nuggetbucket54/CanSat/README.md

# Team TurkeyBurkey CanSat

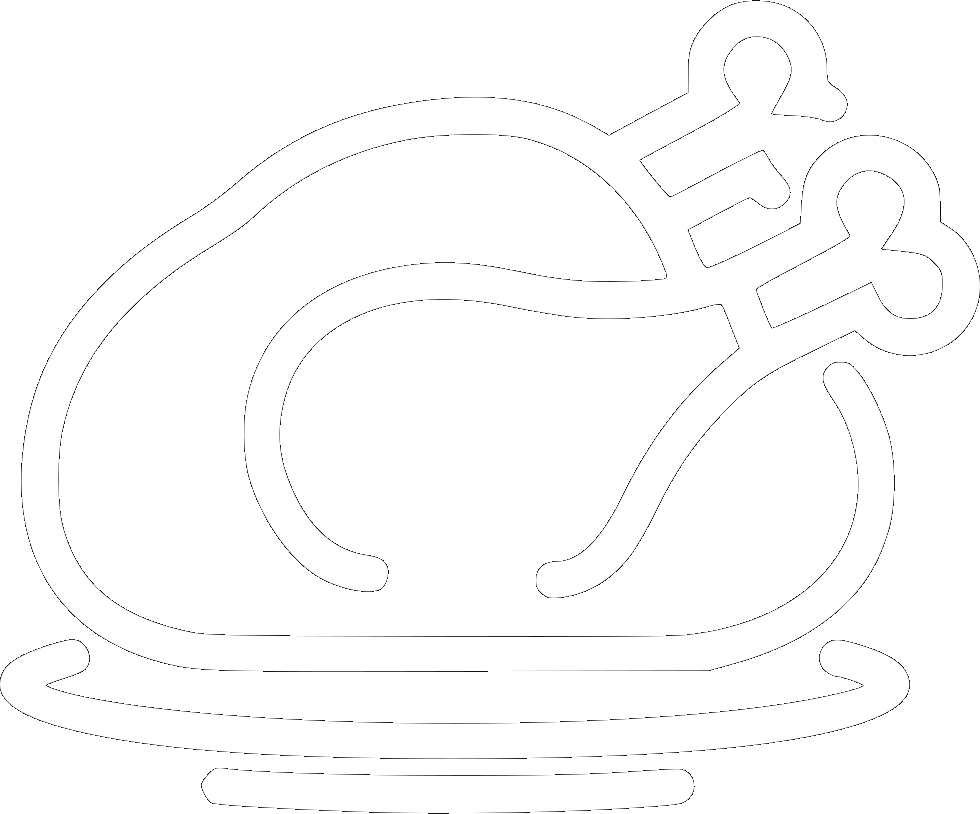
[picture p1: images/turk.png]
TurkeyBurkey Logo

  
Seismometers are both useful and precise when it comes to measuring earthquakes or tremors. In humanity’s ongoing efforts in interplanetary exploration, scientists have developed an abundance of methods to assess the inhabitability of celestial bodies. However, to our understanding, there is yet to be any way to remotely test seismic activities—one must conduct these tests on the surface of these planetary bodies.

Our CanSat converts the seismograph measurements to the Shindo scale and determine the magnitude of the tremors and accomplishes the following:

* Maintain structural and functional integrity while under the forces of launch/freefall.
* Collect air temperature and pressure data during freefall.
* Measure and record vibrations and tremors upon landing.
* Maintain a stable radio connection during freefall and landing over which experimental data may be transmitted.
* Receive accurate and precise data.

## Construction
The CanSat is built around the Arduino NANO V3. Etching and soldering our own circuit boards, these are the components used:
* MPU6050 gyro
* BN220 GPS sensor
* BMP180 barometric sensor
* RYLR896 LoRa radio transmitter/receiver

<p align="center">
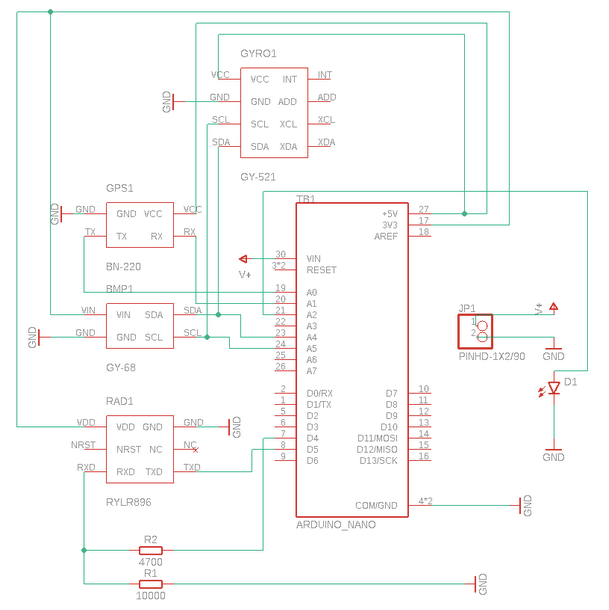
[picture p2: images/pcb.png]
  
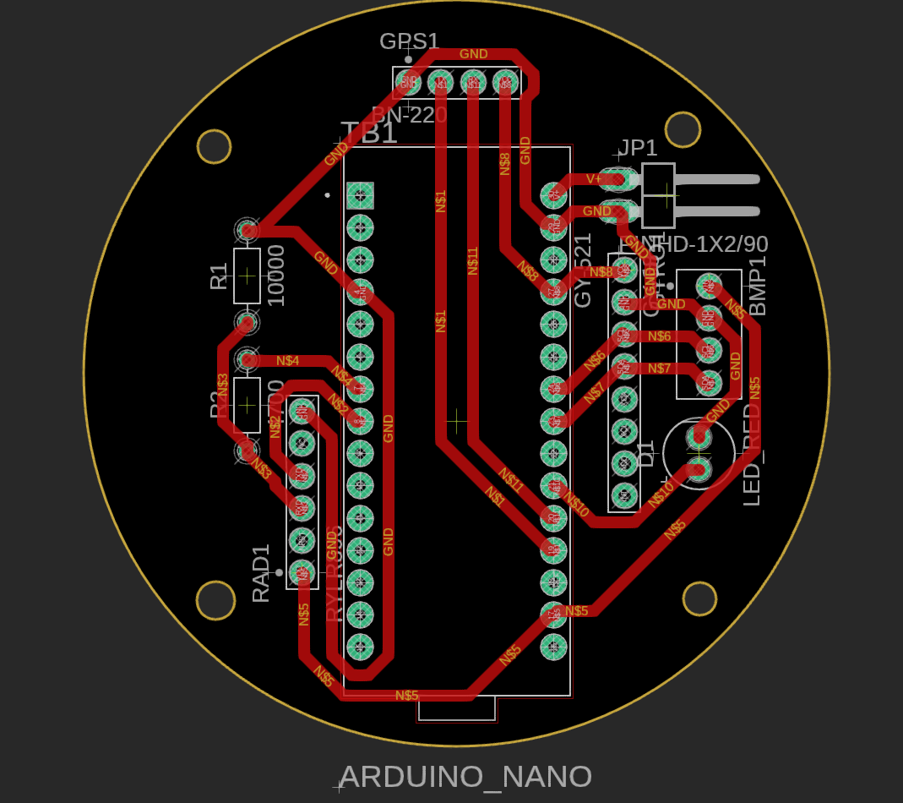
[picture p3: images/pcbdiagram.png]
  
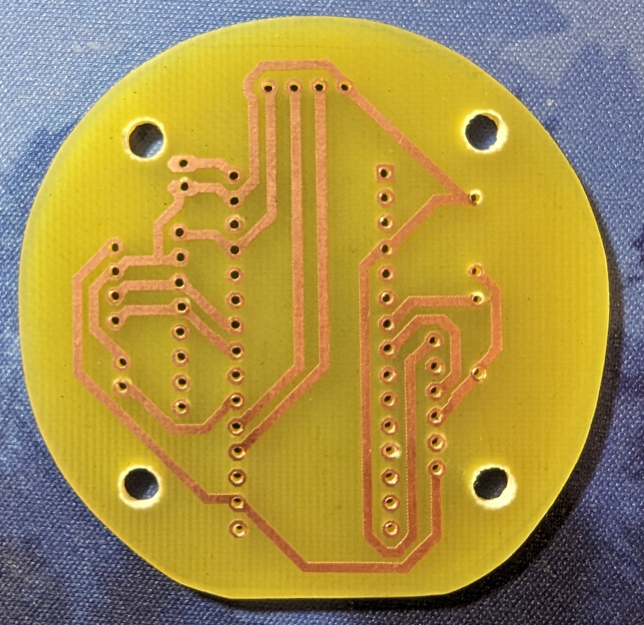
[picture p4: images/pcbetched.jpg]
   <br>
  (left to right) circuit diagram, PCB schematic, etched and drilled circuit <br> <br>
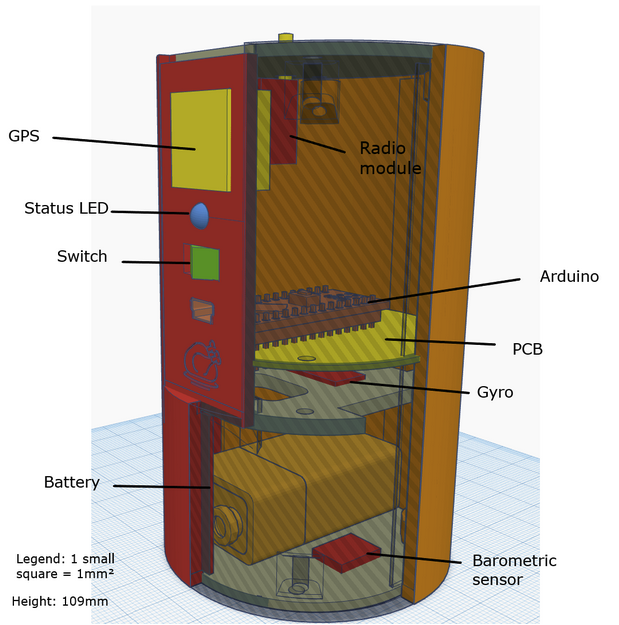
[picture p5: images/cansat.png]
   <br>
  A diagram showing how the CanSat fits together
</p>

## The Seismometer
Due to the size constraints of the CanSat, the accuracy of the seismometer was achieved through software rather than hardware, relying on an MPU6050 Arduino module. This gyro converts physical movements from seismic activity into electrical signals through the analog inputs of the arduino. The entire process of parsing this data has already been studied extensively by the Japanese Meteorological Agency (JMA) and has been further developed to meet the needs of our CanSat. Our process is as follows:

1.  Get the X, Y, and Z angles and calculate the X-, Y-, and Z-components of measured acceleration
2.  Take multiple measurements in a short span of time (in our case 12 measurements every 0.12 seconds)
3.  Apply a Fourier transform to the 12-item datasets for the two horizontal (X and Y) and single vertical (Z) acceleration components, separating each acceleration into multiple trigonometric functions

<p align="center">
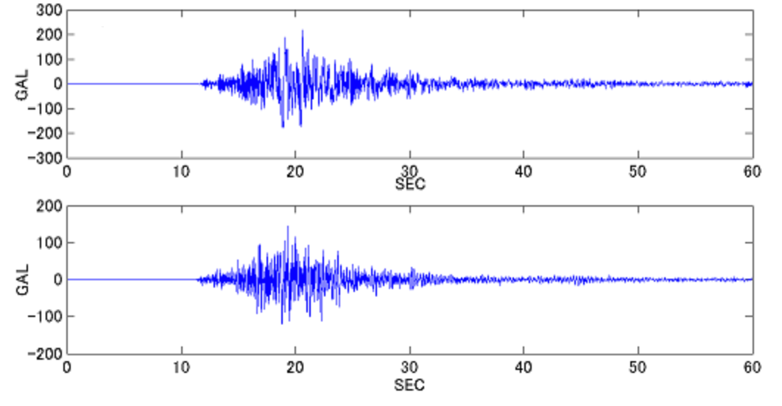
[picture p6: images/prefourier.png]
  
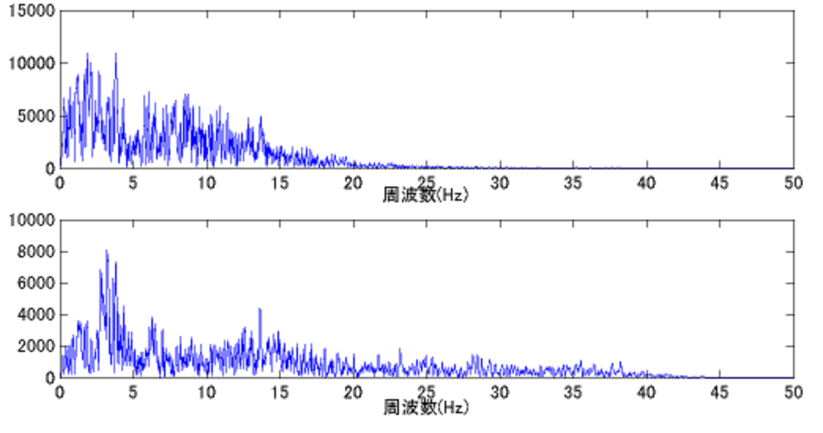
[picture p7: images/postfourier.png]
   <br>
  An example of a Fourier transform of seismometer data from the 2000 Earthquake in Tottori, Japan <br>
  (left) pre-Fourier transform, (right) post-Fourier transform
</p>

4.  Multiply these trigonometric functions by constants calculated by the JMA to “smooth” out the data, reducing instrumental noise

<p align="center">
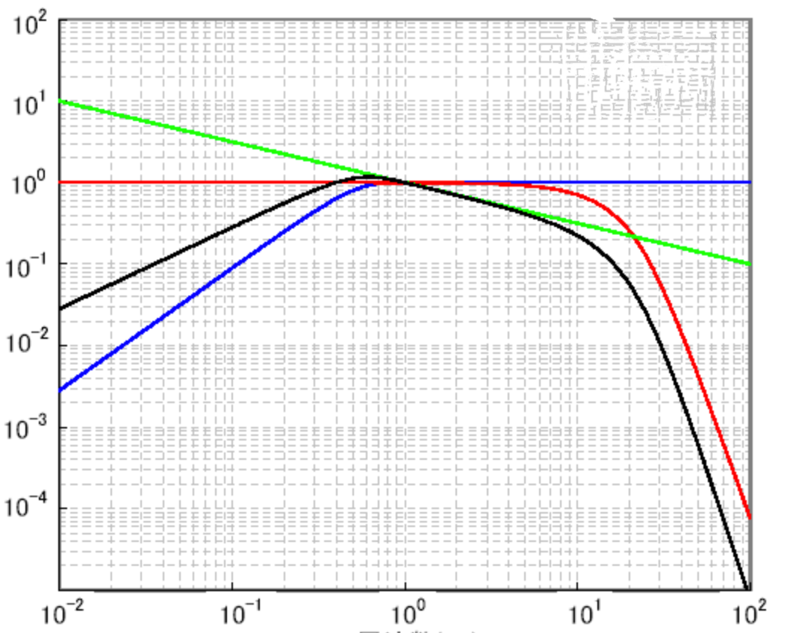
[picture p8: images/filters.png]
   <br>
  (blue) high-cut filter removing high noise, (red) low-cut filter removing low noise, (black) data, (green) filtered data
</p>

5.  Perform the inverse Fourier transform that was applied in step 3 to merge the trigonometric functions back into the respective X-, Y-, and Z-components
6.  Synthesize these three components into a single vector

<p align="center">
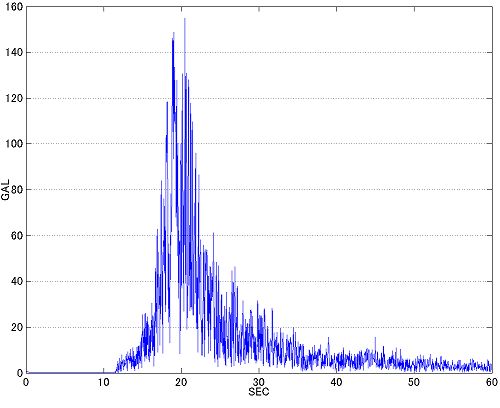
[picture p9: images/composite.PNG]
   <br>
  The composite of the acceleration calculated by the seismometer after compiling all filtered data
</p>

7.  Convert measurements into the Shindo scale using formula `Intensity = 2 log a + 0.94` where a is the acceleration of the synthesized vector in gals (1 cm/s^2)

## CanSat Results
### Launch
Unfortunately, the rocket in which TurkeyBurkey was launched in experienced unexpected results—the motor burnt through and prematurely released the CanSat, damaging our CanSat beyond repair

<p align="center">
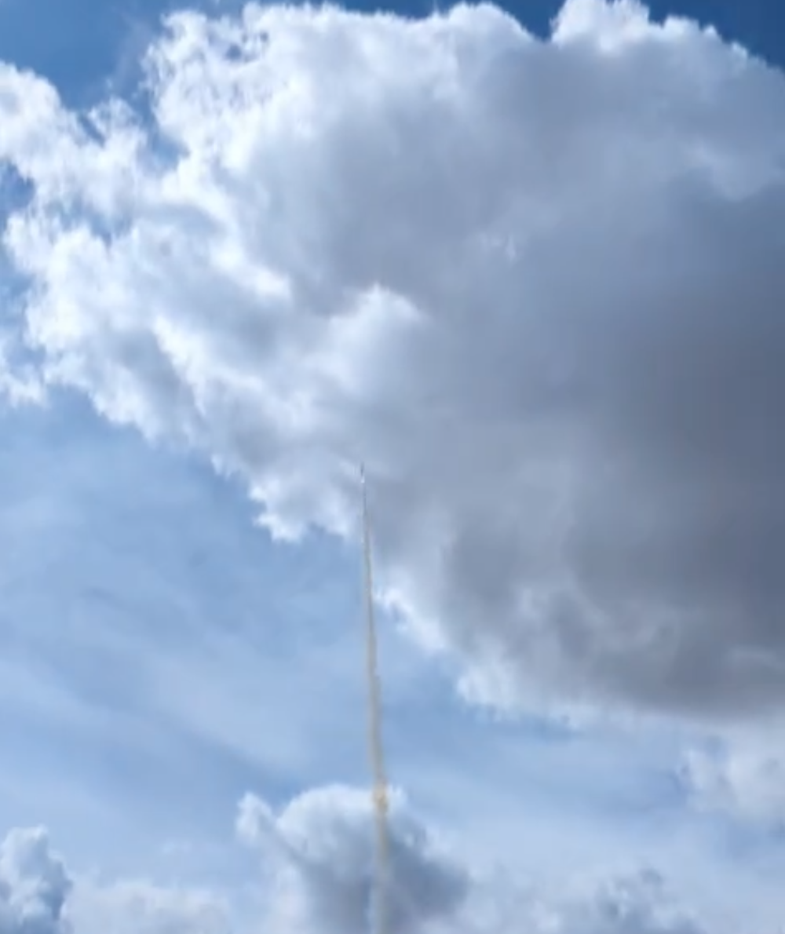
[picture p10: images/fail1.png]
  
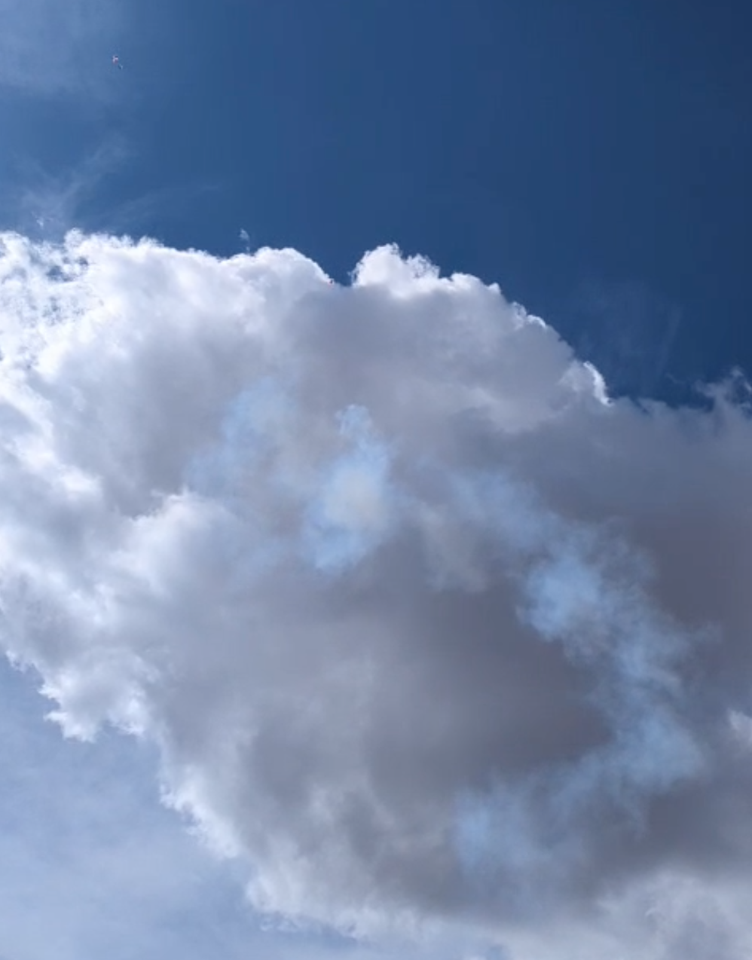
[picture p11: images/fail2.png]
  
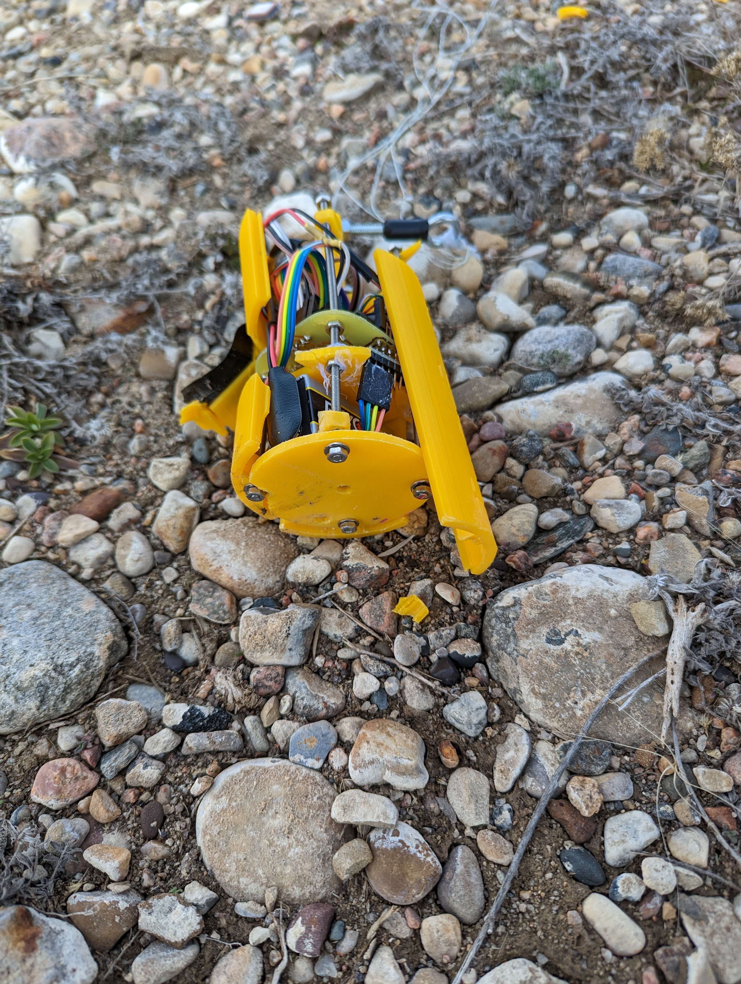
[picture p12: images/wreckage1.jpg]
  
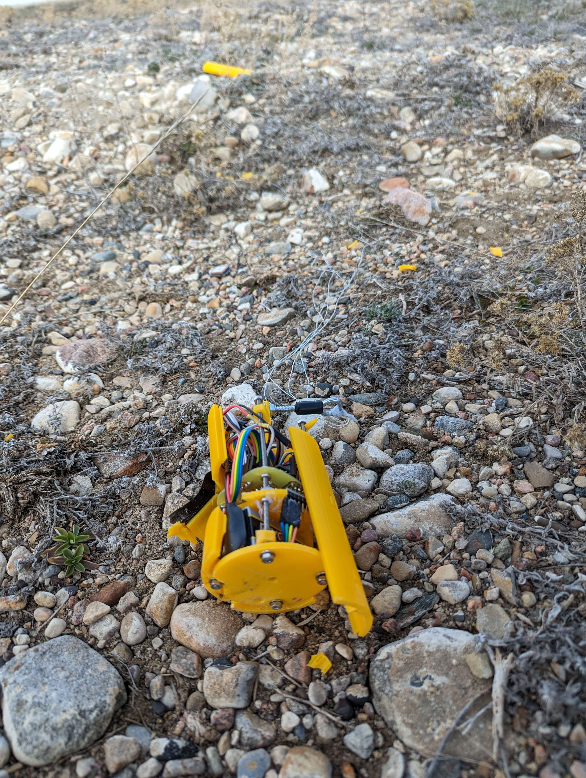
[picture p13: images/wreckage2.jpg]
   <br>
  (left to right) rocket burning out mid-launch, post-mortem CanSat 😔
</p>

### Findings
Due to the rapid unplanned disassembly of the CanSat, team TurkeyBurkey was only able to grab readings while on land and during initial launch (before the burnout of the motor). However, we were able to gather some interesting information nonetheless

<p align="center">
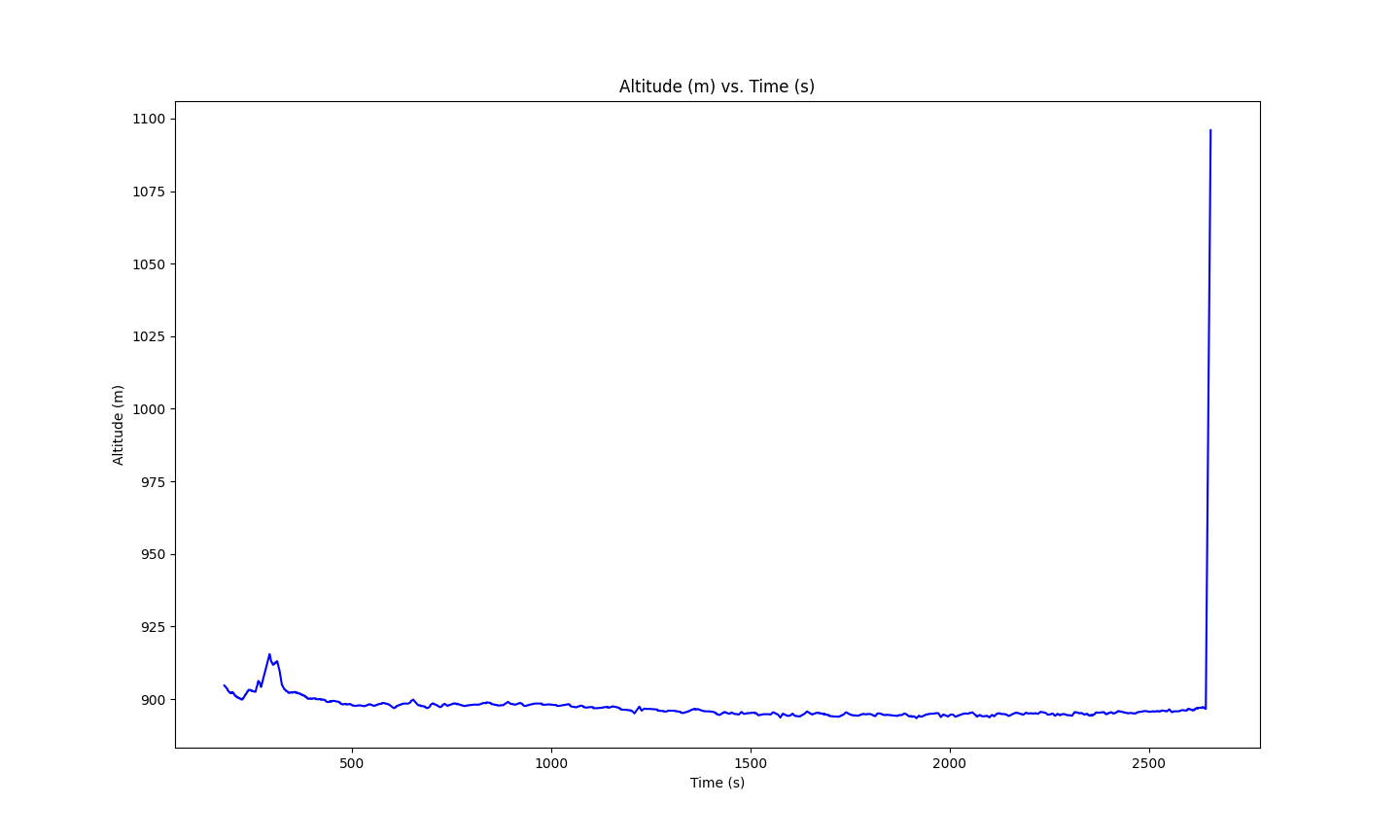
[picture p14: images/altitude-time.png]
   <br>
  The smaller peak likely comes from walking the CanSat to the launch site, while the larger peak comes from the moment of launch <br> <br>
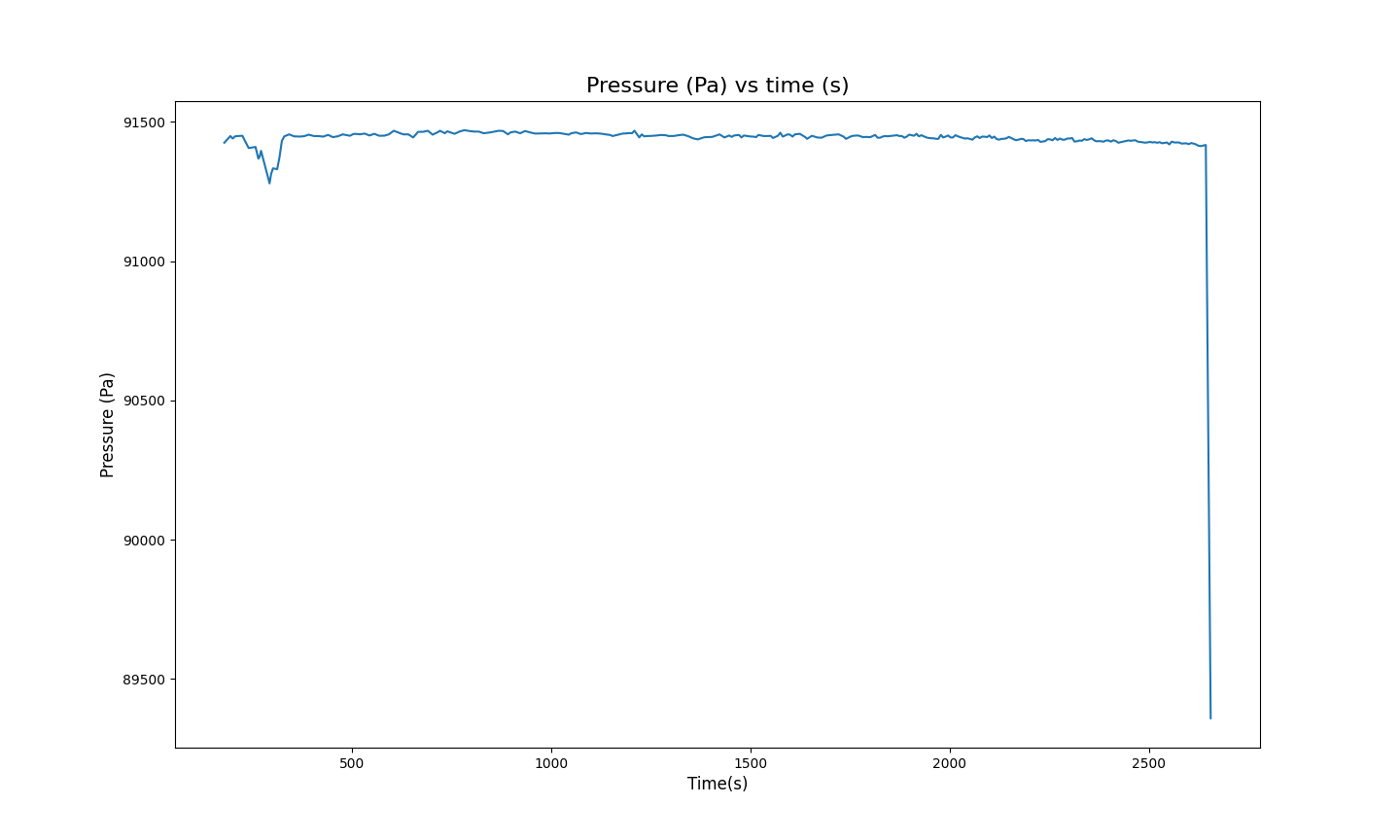
[picture p15: images/pressure-time.png]
   <br>
  The pressure remains relatively constant until the sudden launch of the rocket, in which the pressure quickly decreases. The earlier dip could be from fitting the satellite into the rocket <br> <br>
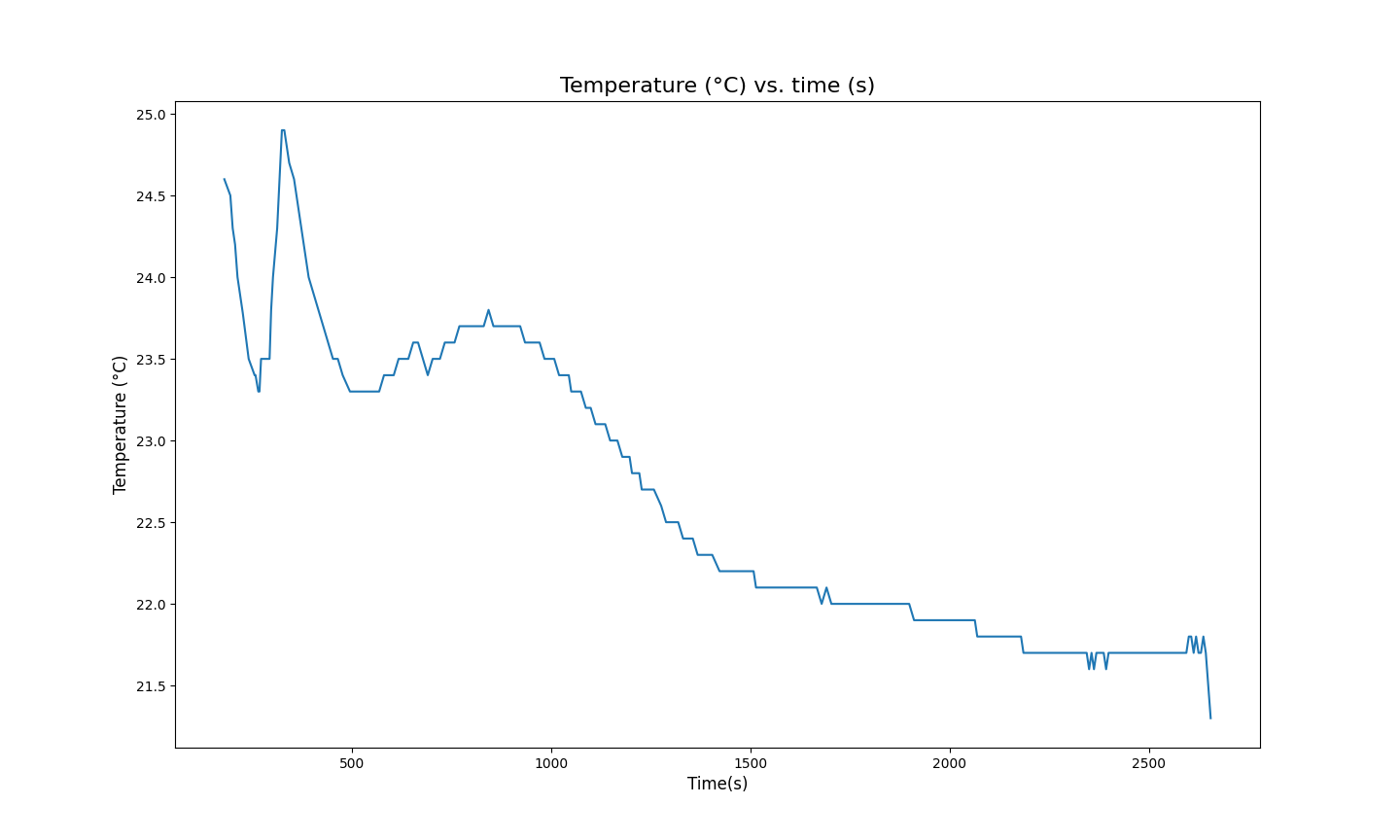
[picture p16: images/temperature-time.png]
   <br>
  Temperature slowly decreases while in the rocket as it is moved out of the sunlight <br> <br>
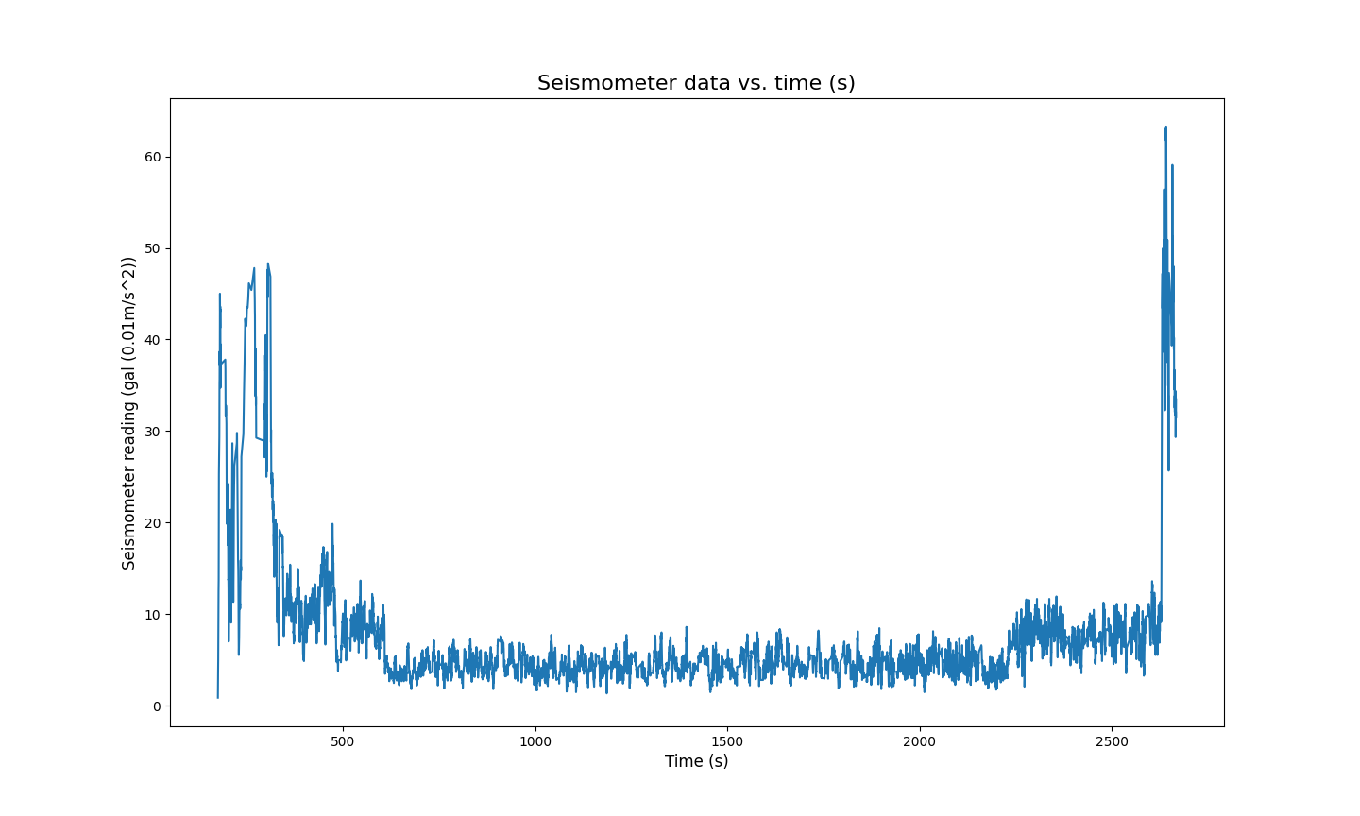
[picture p17: images/seismometer-time.png]
   <br>
  Two peaks: when the CanSat is walked to the launch site, and when it is launched by the rocket. 
</p>

While stationary, the seismometer records a 2 on the Shindo scale, which is roughly expected given the noise of our instruments (despite our best efforts at mitigating this with Fourier transforms). Additionally, the seismometer was tuned to record smaller measurements as we did not expect any actual earthquakes to occur and thus, the larger readings may not be as accurate.

### Achievements
Even with the tragic demise of our CanSat, team TurkeyBurkey still managed to snatch the dub for the "Science Mission Award." This award was given based off the scientific research and soundness of the secondary mission. 

<p align="center">
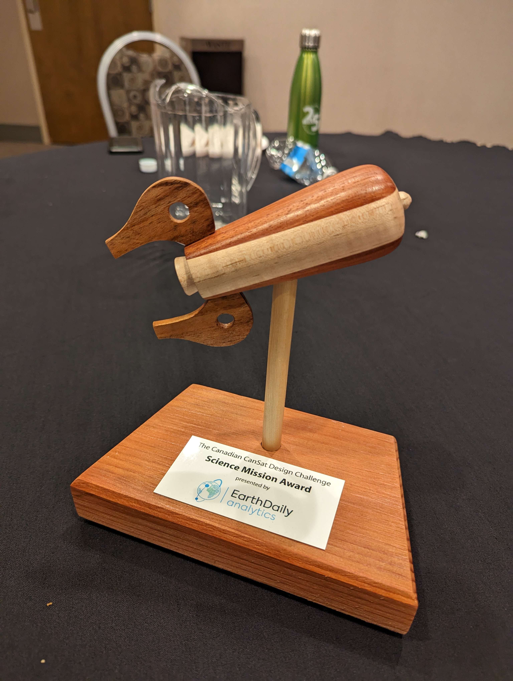
[picture p18: images/award.jpg]
  
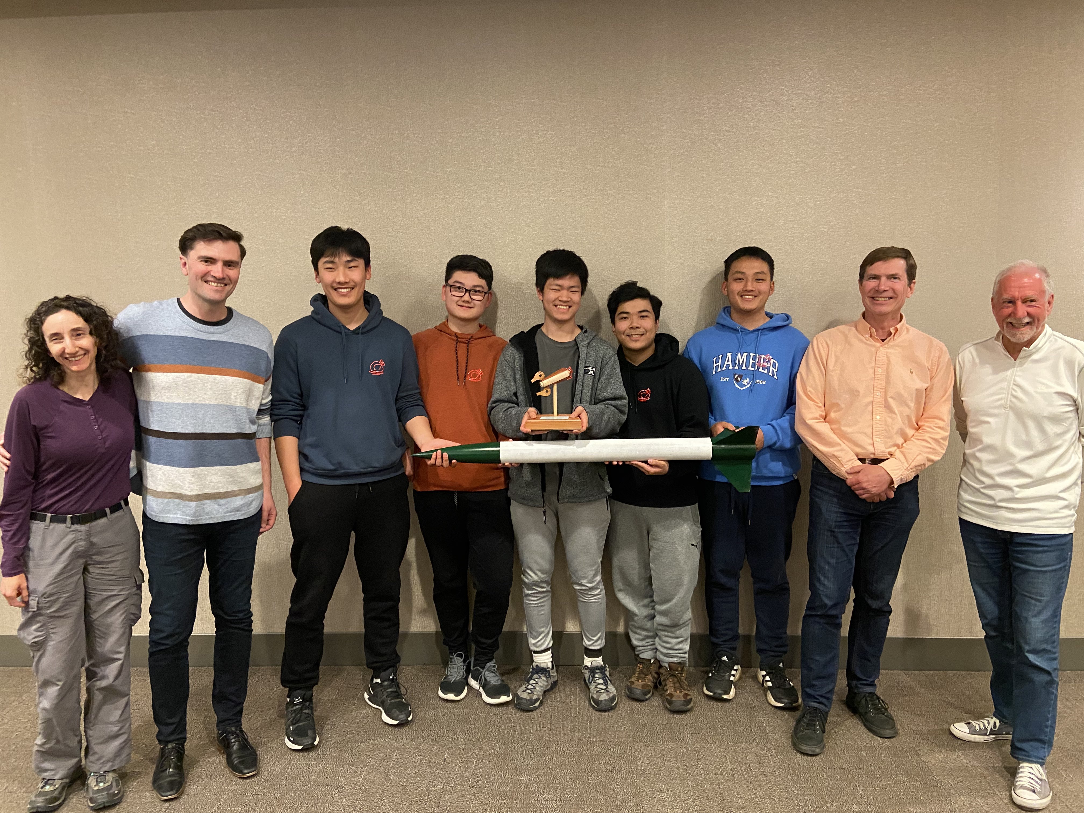
[picture p19: images/award-team.jpg]
   <br>
  The award and the team 😊
</p>

## Running the TurkeyBurkey CanSat!!!
For some reason, if you wish to embark on a journey to build this TurkeyBurkey CanSat, you should probably download these libraries:
* [BMP180 library by Adafruit](https://github.com/adafruit/Adafruit-BMP085-Library)
* [BusIO library by Adafruit](https://github.com/adafruit/Adafruit_BusIO)
* [Filters library by JohnHub](https://github.com/JonHub/Filters)
* [Light MPU6050 library by rfetick](https://github.com/rfetick/MPU6050_light)
* [TinyGPS library by mikalhart](https://github.com/mikalhart/TinyGPSPlus)

After installing all libraries, connect the CanSat to a ground station. Connect the ground station to a computer and run `python3 script.py` to append information to a .txt file in realtime. Next, run `python3 assign.py` to transcibe text information into an Excel spreadsheet. Finally, run `python3 grapher.py` to create a mtaplotlib graph of the data.
