nuggetbucket54/CanSat/images/bubly-altitude.png

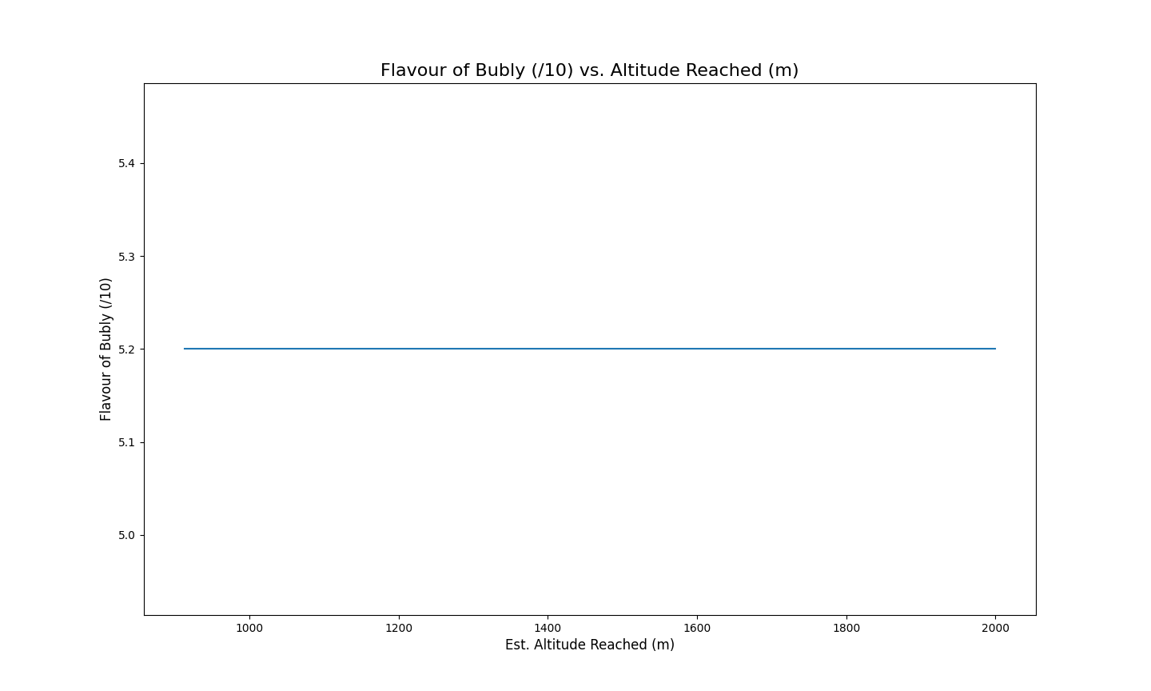
images/bubly-altitude.png
