nuggetbucket54/CanSat/images/pcbschematic.png

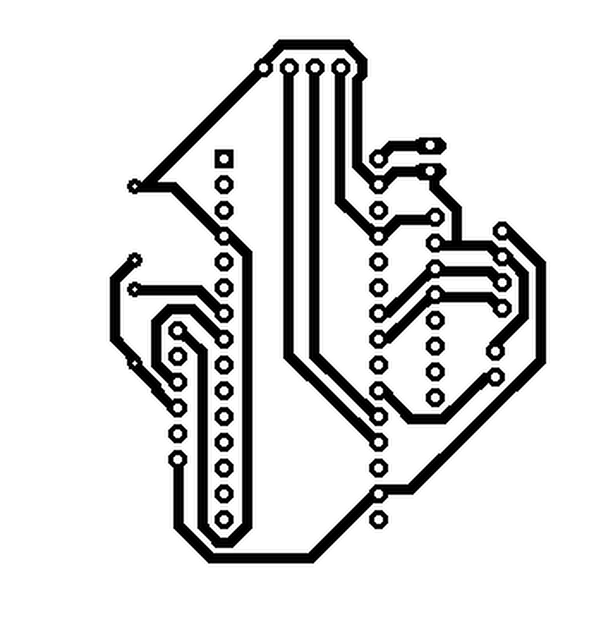
images/pcbschematic.png
