nuggetbucket54/CanSat/images/pressure-altitude.png

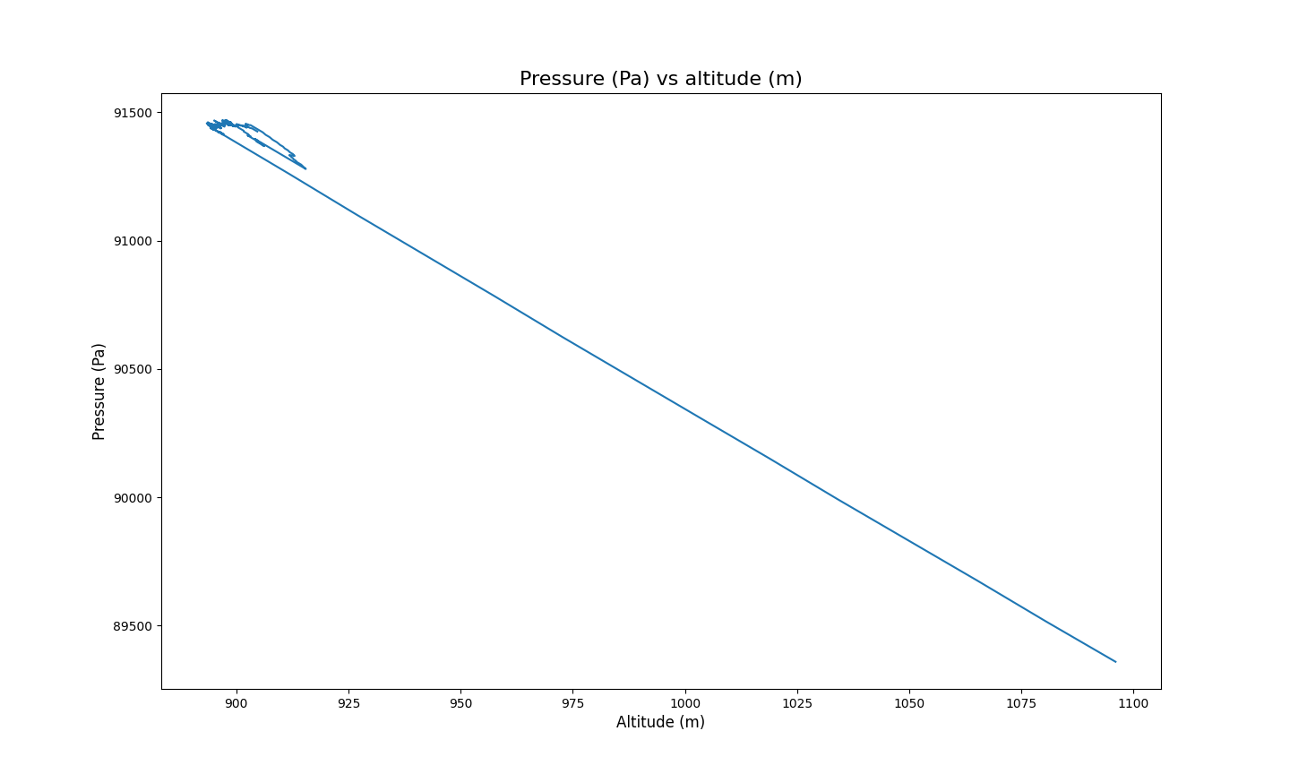
images/pressure-altitude.png
