nuggetbucket54/CanSat/images/temperature-altitude.png

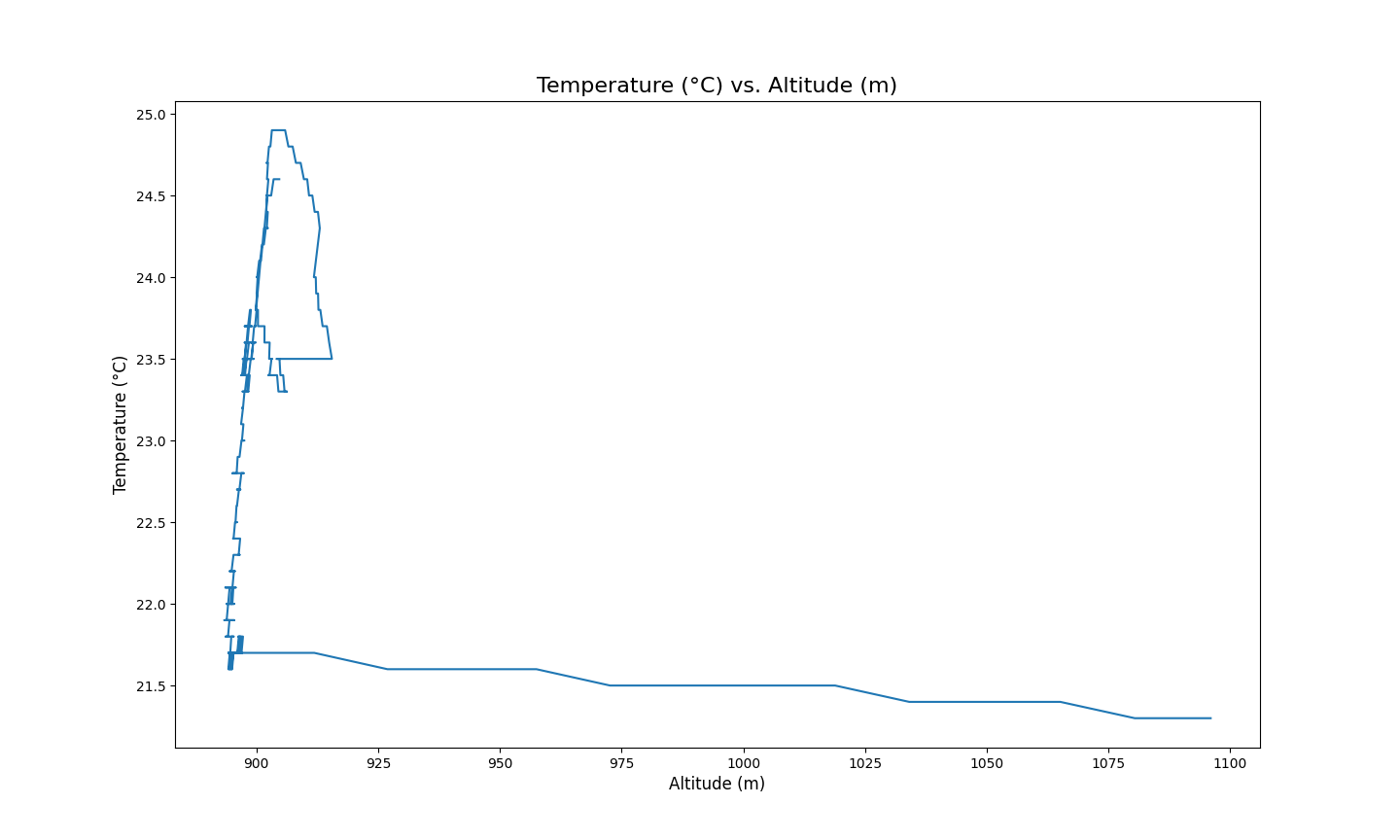
images/temperature-altitude.png
