nuggetbucket54/CanSat/images/temperature-pressure-time.png

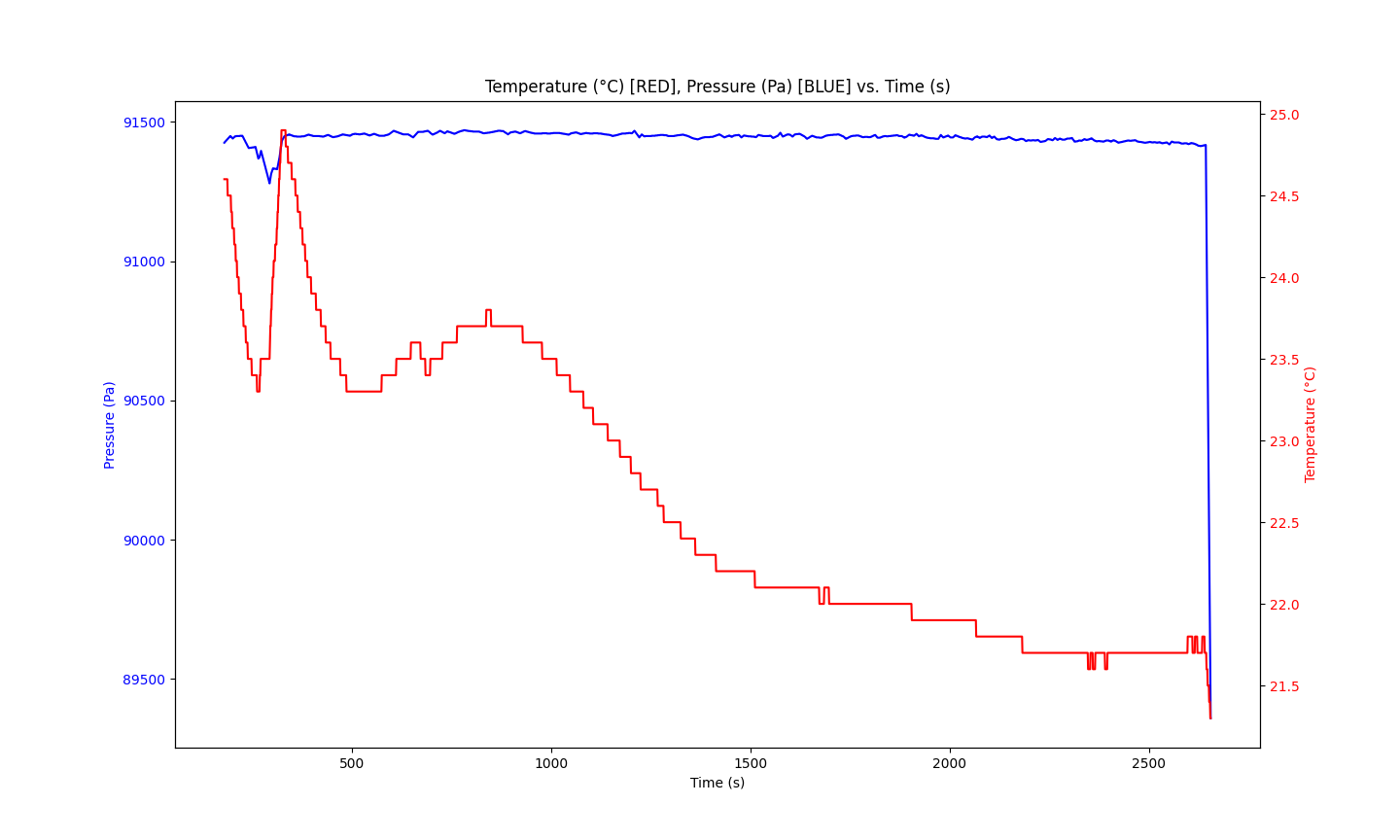
images/temperature-pressure-time.png
