nuggetbucket54/CanSat/(commit log)

2023-03-07 created arduino folder
2023-03-09 meme servo code
2023-03-31 added sd card and status LED
2023-04-06 somewhat buggy data storage, re added smart delay
    [groundstation.ino]
2023-04-06 switched BMP and decreased precision of BMP measurements
2023-04-13 added screens of ground stations
2023-04-13 working display switch button
2023-04-13 some ground station changes and updated pinout
2023-04-13 switched pins again
2023-04-19 added filters image
2023-04-19 Update README.md
    extended readme materials
2023-04-19 changed script.py to just grab some sample data for now
2023-04-20 updated images
    [data.xlsx]
2023-04-22 sketch changes, cansat fixes
    [groundstation.ino, script.py, sketch.ino]
2023-04-22 added excel writing for all data
    [data.xlsx]
2023-04-22 deleted excel file content
    [data.xlsx]
2023-04-22 added data recording
    [data.xlsx]
2023-04-22 fixed baud and delay
    [script.py, sketch.ino]
2023-04-23 added matplotlib graphs and finished processingn data xlsx file
    [data.xlsx]
2023-04-25 moved data-related programs and files to a separate directory
    [data.xlsx]
